hhintoglu/Capstone_Design_by_Project_Automata_Technologies/README.md

# Capstone_Design_by_Project_Automata_Technologies
Capstone Design Project repository. All rights reserved by AutomataTechnologies®
