hhintoglu/Capstone_Design_by_Project_Automata_Technologies/Presentation/Electromechanical Subsystem.pptx

## Electromechanical Subsystem

Huzeyfe Hintoglu

## Outline

- Mechanical Design
- Actuator System Design

## Mechanical Design

- Objectives&Requirements
  - Light and Compact Design
  - Neatness
  - Durability (Mechanically)
  - Inexpensive

## Mechanical Design


## Shooting Mechanism


## Actuator System

- Objectives&Requirements
  - Agile Movement
  - Durability (in Power Aspect)
  - Inexpensive

## Slide 7

Agile Movement

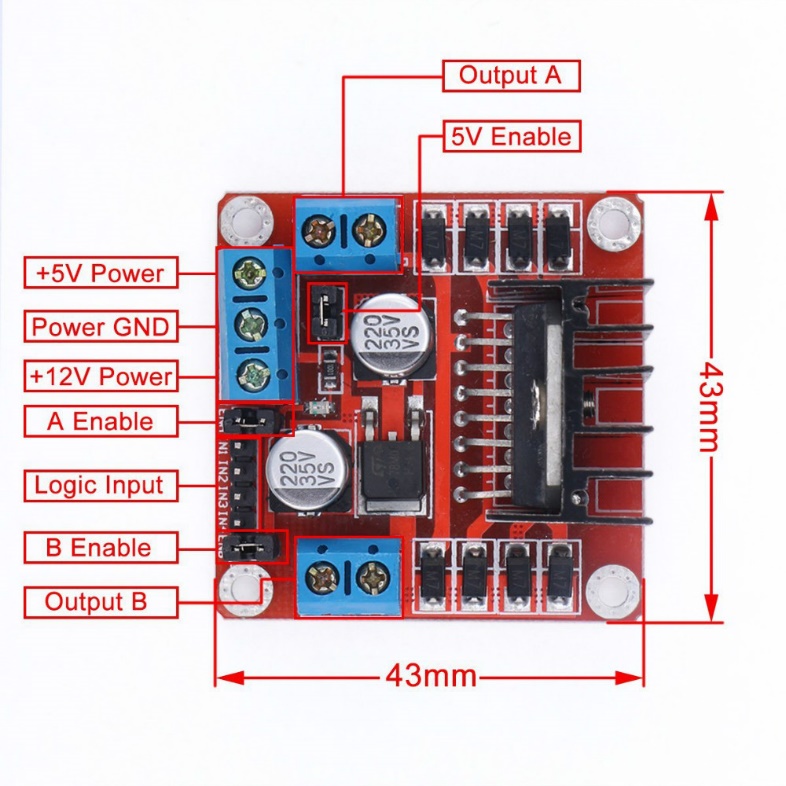
[picture p67: figure]
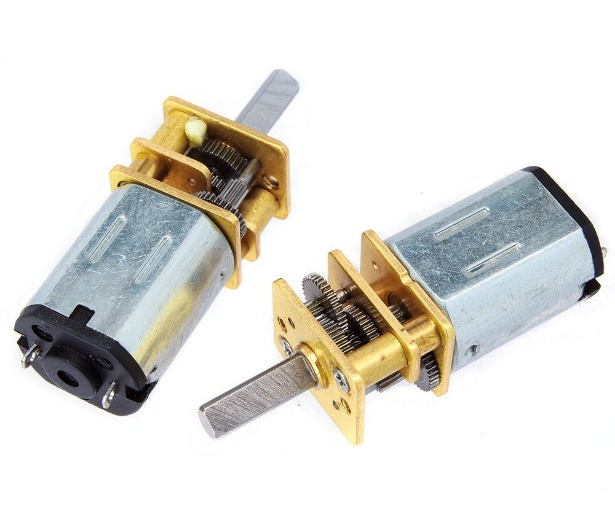
[picture p68: figure]

## Camera Movement

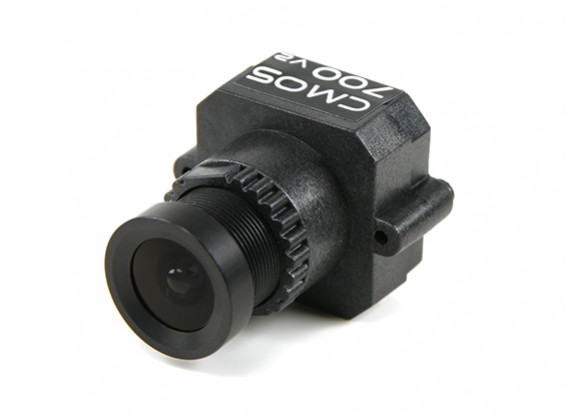
[picture p69: figure]

## Power


5200maH
Li-Po
2Cell 7.4V
30C

## Power Analysis of Robot

Component | Power Consumption
Shooting Mechanism | 0.45W (One shot)
Camera Movement | 0.42W (Continous Rotation)
Camera | 1W
Transmitter | 3.5W
Motor Movement | 4.8W
Reciever | 0.2W
Total | 10.37W
Battery Capacity | 38.5 Wh

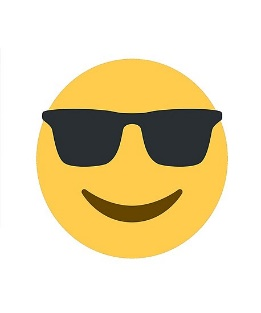
[picture p70: figure]

Time = Battery Capacity/ Total = 4 Hours
