hhintoglu/Capstone_Design_by_Project_Automata_Technologies/Presentation/Control Subsystem.pptx

## Control Subsystem

Fatih ÇALIŞ

## Problem Statement and Requirements

- Good Control Algorithm
  - High Maneuver Capability
- Easeness of the operation
  - 3 Continuous Variables
  - 2 Digital Variables

## Solutions

- Differential Drive Method
  - Rotation around its own axis

## Slide 4

- 3 Continous Variables:
  - Movement in Y direction
  - Movement in X direction
  - Angle of FPV camera
- 2 Digital Variables:
  - Shooting Action
  - Choosing Mode

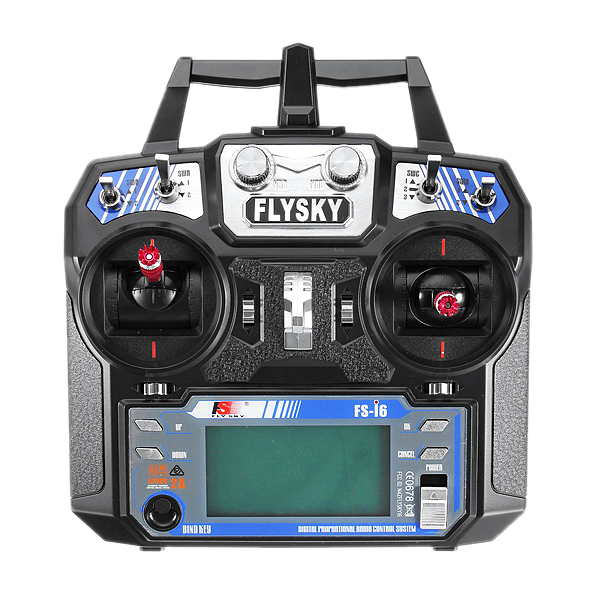
[picture p96: figure]
elektronik eşyalar, kamera, gök içeren bir resim Açıklama otomatik olarak oluşturuldu

## Implementation

Sensors

Microcontroller

RC Transmitter

FPV Display

Remote Control

RC Receiver

Servo Motor

FPV Camera

Motor Driver

Motor Driver

DC Motors

Step Motor

On-Board Control

## Test Results

- RC Transmitter Tests:
  - Range:
    - Line of Sight : Around 250m
    - With Obstacles: Around 100m
- Sensor Tests:
  - Distance Sensor (HCSR-04):
    - Measurement Range: 1cm – 400cm
    - Without Delay : 1cm – 50cm
  - Color Sensor (TCS3200)
    - Requires good threshold adjusting
