hhintoglu/Capstone_Design_by_Project_Automata_Technologies/Presentation/Conclusion.pptx

## CONCLUSION

FATİH ÇAM

## DELIVERABLES

1. Equipments
2. Documents
3. Software

## EQUIPMENTS

- Vehicle(Robot)
- Play Field
- Ball
- Goals
- Control Interface

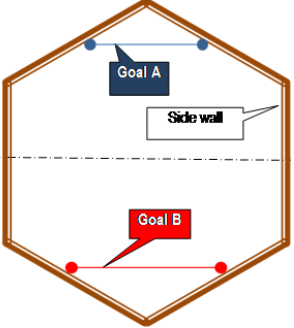
[picture p119: figure]
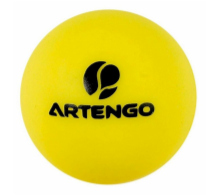
[picture p120: figure]
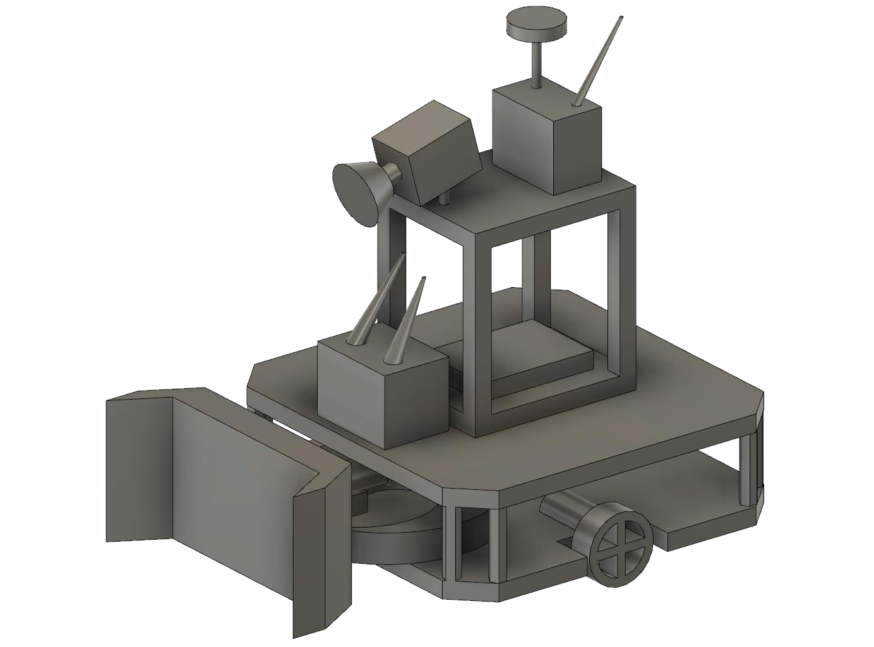
[picture p121: figure]

## DOCUMENTS and SOFTWARE

- Warranty
- Manual
- USB Flash Bellek

## COST ANALYSIS

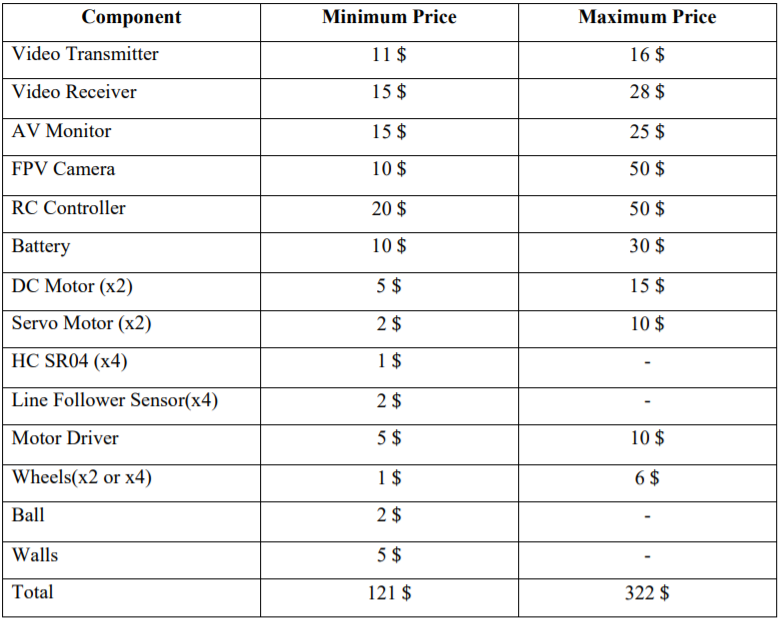
[picture p122: figure]

## TIME PLAN

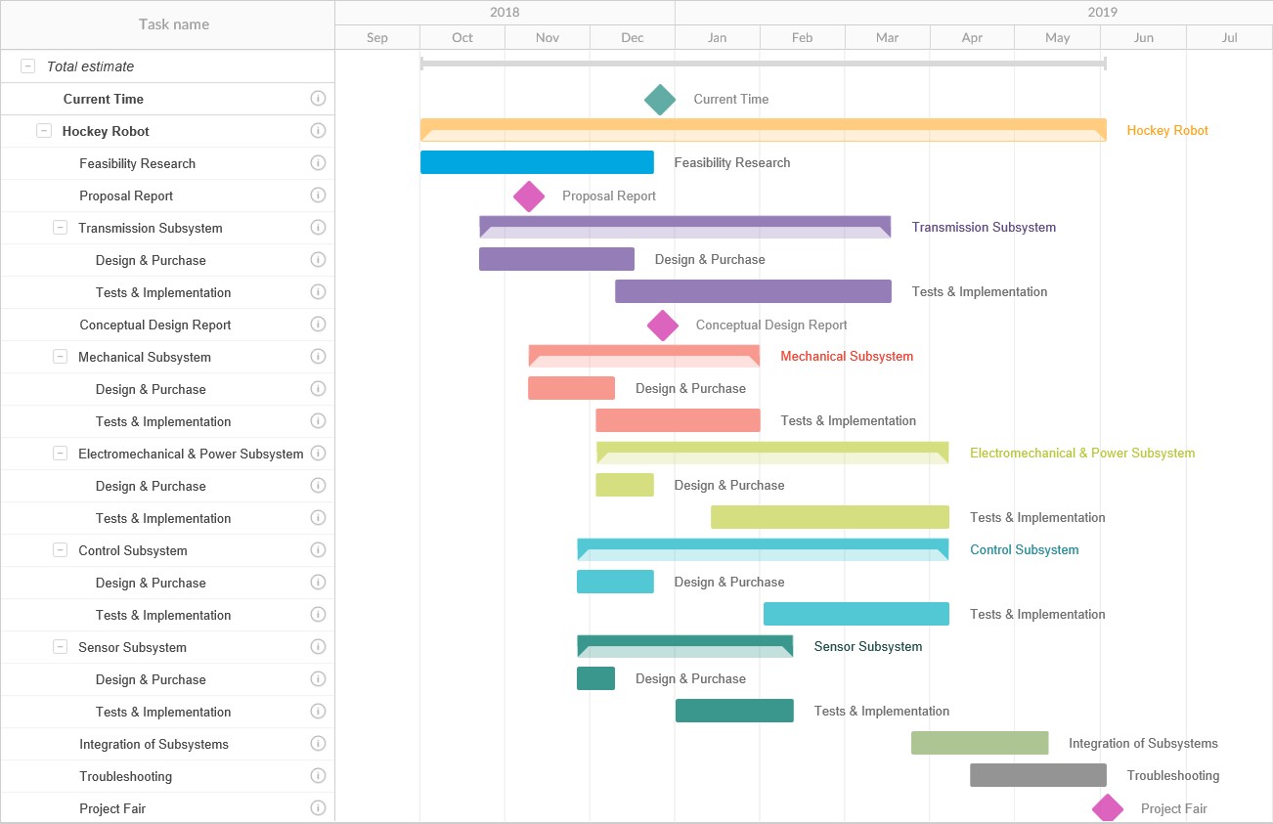
[picture p123: figure]

## FUTURE PLAN

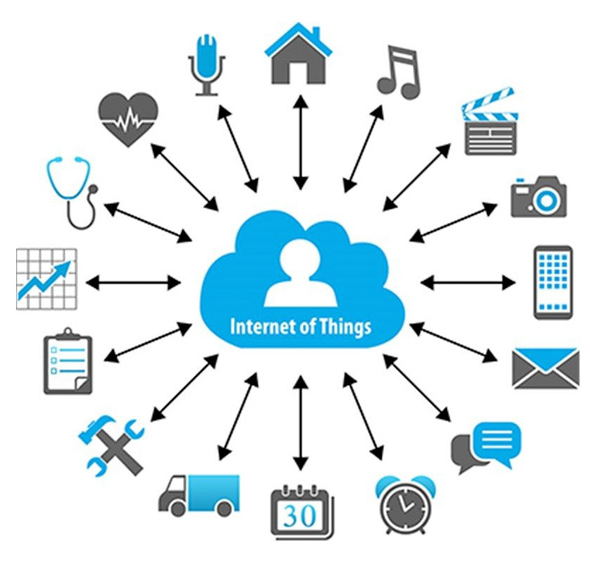
[picture p124: figure]
