hhintoglu/Capstone_Design_by_Project_Automata_Technologies/Presentation/Telecommunication Subsystem.pptx

## Transmission Subsystem

Recep GÜNAY

## Problem Statement and Requirements

- Latency
  - Low latency
- Interference
  - Interference free

## Solutions

## Solutions

- Latency:
  - Analog video data
  - Trade-off between quality
- Interference:
  - Circular Polarized Waves
  - Low signal power
  - Multiple channels in different bands

## Test Results

- Range:
  - 200m in line of sight
  - 40m with obstacles
- Interference:
  - No multipath interference
  - No interference with another system in different channels
- Latency:
  - Less than 80ms within a 10m radius
  - Up to 200ms at around 30m

## Test Results

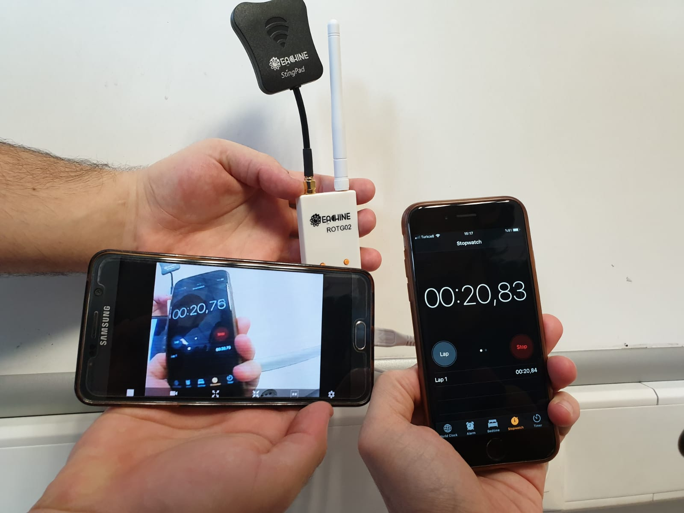
[picture p125: figure]
kişi, tutma, el, duvar içeren bir resim Açıklama otomatik olarak oluşturuldu

## Alternative Solutions

- 3G/4G modules
  - Upload and download video anywhere
- Feature transmission
  - Image processing
