hhintoglu/Capstone_Design_by_Project_Automata_Technologies/3D Drwaings - Final Version/Robot - ISO left Top.png

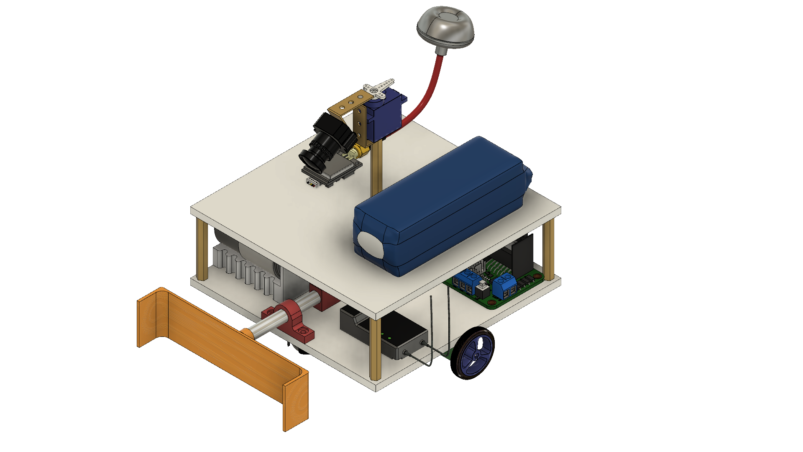
3D Drwaings - Final Version/Robot - ISO left Top.png
