hhintoglu/Capstone_Design_by_Project_Automata_Technologies/Conceptual Design Report/Chassis v1.png

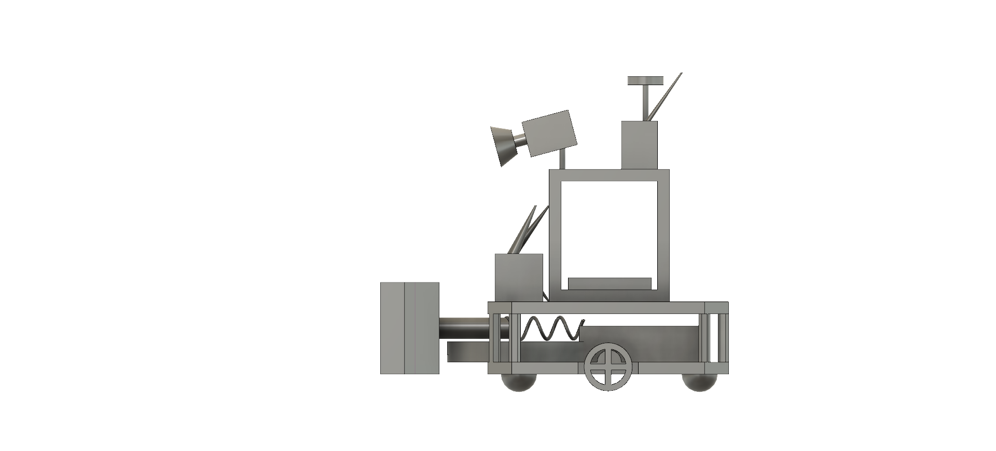
Conceptual Design Report/Chassis v1.png
