hhintoglu/Capstone_Design_by_Project_Automata_Technologies/Conceptual Design Report/Shooting Mech Ver2.png

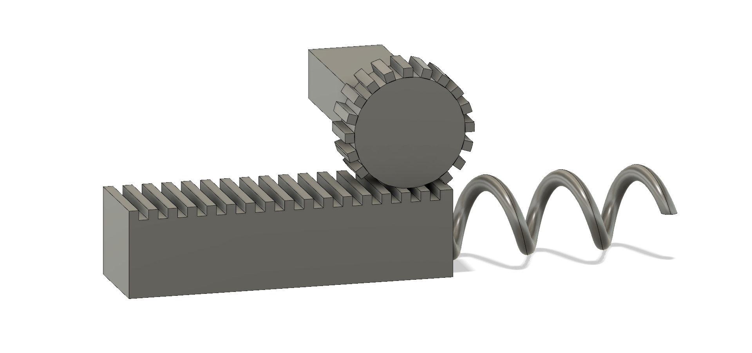
Conceptual Design Report/Shooting Mech Ver2.png
