hhintoglu/Capstone_Design_by_Project_Automata_Technologies/Conceptual Design Report/Spring Mech v9.1.png

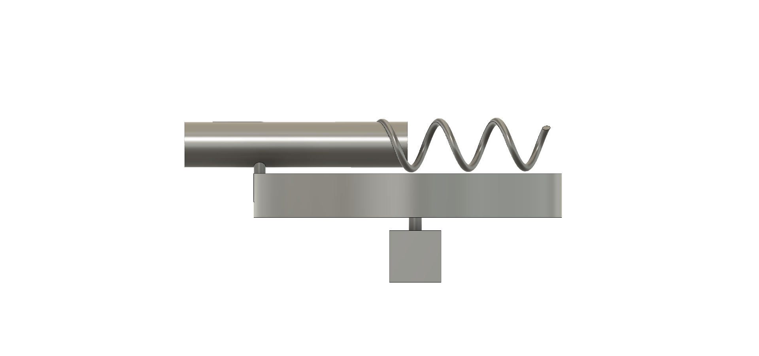
Conceptual Design Report/Spring Mech v9.1.png
