hhintoglu/Capstone_Design_by_Project_Automata_Technologies/Critical Design Report/Chassis Right.png

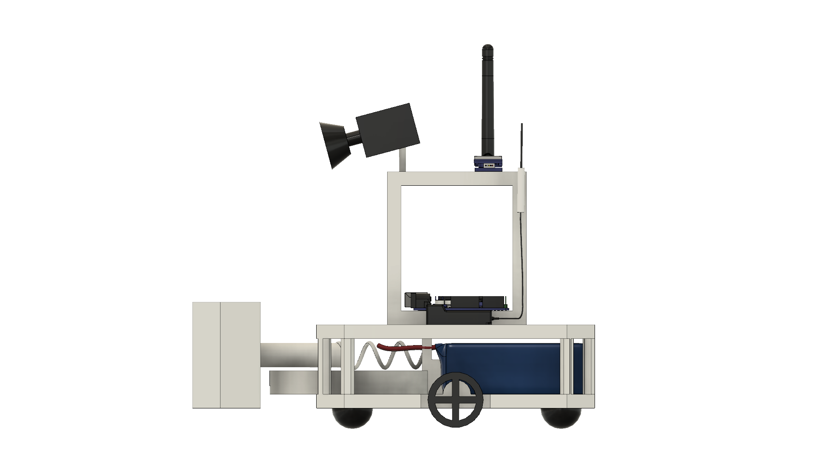
Critical Design Report/Chassis Right.png
