hhintoglu/Capstone_Design_by_Project_Automata_Technologies/Critical Design Report/Chassis TOP.png

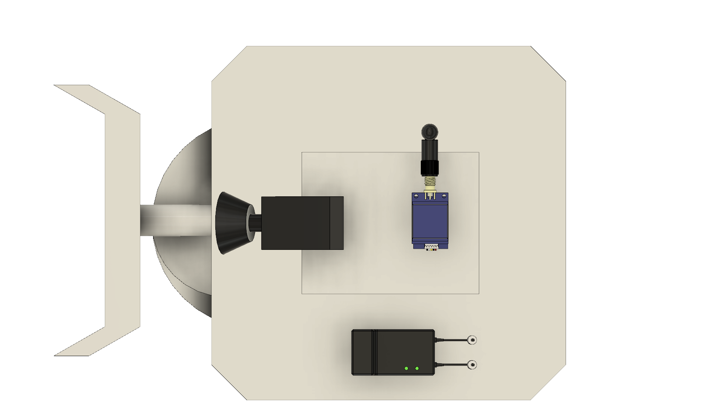
Critical Design Report/Chassis TOP.png
