hhintoglu/Capstone_Design_by_Project_Automata_Technologies/Critical Design Report/Chassis v5.1.png

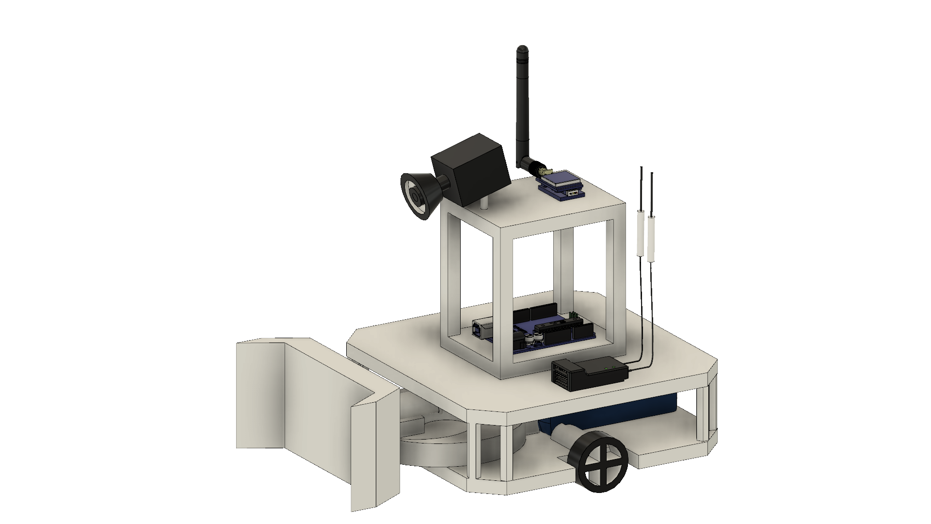
Critical Design Report/Chassis v5.1.png
