hhintoglu/Capstone_Design_by_Project_Automata_Technologies/Financial Management/Cost Analysis.xlsx

Purchase / Contribution | Purchased Component | Total Cost | Date | Link
Purchase | 2* Arduino Nano | 4.02$ (21.56₺) | 2018-10-26 | Aliexpress (https://tr.aliexpress.com/item/1pcs-lot-Nano-3-0-controller-compatible-for-arduino-nano-CH340-USB-driver-NO-CABLE/32824272738.html)
Purchase | 2*NRF24L01 | 3.96$ (21.24₺) | 2018-12-01 | Aliexpress (https://tr.aliexpress.com/item/Free-Shipping-NRF24L01-PA-LNA-Wireless-Module-with-Antenna-1000-Meters-Long-Distance-FZ0410-We-are/32810139818.html)
Purchase | Eachine ROTG02 Receiver | 18.99$ (112.89₺) | 2018-12-13 | Banggood (https://www.banggood.com/Eachine-ROTG02-UVC-OTG-5_8G-150CH-Dual-Antenna-Audio-FPV-Receiver-for-Android-Tablet-Smartphone-p-1242422.html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)
Purchase | Caddx EOS2 FPV Camera | 13.25$ (72.05₺) | 2018-12-15 | Banggood (https://www.banggood.com/Turbo-EOS1-1200TVL-2-1mm-13-CMOS-169-Mini-FPV-Camera-NTSCPAL-For-RC-Drone-p-1278882.html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)
Purchase | Eachine TX801 Transmitter | 12.95$ (70.41₺) | 2018-12-15 | Banggood (https://www.banggood.com/Eachine-TX801-5_8G-72CH-0_01MW5MW25MW50MW100MW200MW400MW600MW-Switched-AV-VTX-FPV-Transmitter-p-1147691.html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) | Total Money:
Purchase | Eachine VR D2 Antenna | 4$ (21.69₺) | 2018-12-15 | Banggood (https://www.banggood.com/Eachine-VR-D2-FPV-Goggles-Spare-Part-RP-SMA-6dBi-5_8GHz-Mushroom-Antenna-p-1086640.html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) | 35.88₺
Purchase | Eachine StingPad Antenna | 5$ (27.13₺) | 2018-12-15 | Banggood (https://www.banggood.com/Eachine-StingPad-5_8G-16dBi-High-Gain-Flat-Panel-FPV-Antenna-SMARP-SMA-For-Receiver-p-1155223.html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)
Contribution (Huzeyfe) | - | 150₺ | 2018-12-21 | -
Contribution (Sarah) | - | 150₺ | 2018-12-27 | -
Contribution (Fatih Çalış) | - | 150₺ | 2018-12-29 | -
Purchase | 3*DC Motor 6V 350RPM | 97.42₺ | 2018-12-30 | Robotzade (https://www.robotzade.com/6V-350Rpm-Reduktorlu-Mikro-DC-Motor,PR-1171.html)
Purchase | Tplug,Macarons,Cables etc | 41,63₺ | 2018-12-31 | Robotistan (https://www.robotistan.com/t-plug-yuksek-akim-konektor-seti-40-80a)
Contribution (Fatih ÇAM) | - | 150₺ | 2019-01-08 | -
Contribution (Recep) | - | 150₺ | 2019-01-09 | -
Purchase (3D Print) | Motor Mount x 3 | 6₺ | 2019-02-25 | -
Purchase (3D Print) | Spiral V3. + Adapter | 14.50₺ | 2019-03-06 | -
Purchase | Rail | 9.75₺ | 2019-03-06 | -
Purchase (3D Print) | Rack and Pinion v1 | 3₺ | 2019-03-15 | -
Purchase | Aluminum Rod | 20₺ | 2019-03-20 | -
Purchase (3D Print) | Rack and Pinon v3 | 5₺ | 2019-03-26 | -
Purchase | Seperator 8x8cm 8x2.5cm | 13₺ | 2019-03-26 | -
Purchase | 12V 30RPM DC Motor | 99.49₺ | 2019-03-29 | Robotzade (https://www.robotzade.com/index.php?do=catalog/product&pid=1575)
Purchase (3D Print) | Mounts | 20₺ | 2019-04-02
Purchase (3D Print) | Shooting Plate | 6.5₺ | 2019-05-11 | -
Purchase (2D Print) | Poster | 27.5₺ | 2019-05-13 | -
