hhintoglu/Capstone_Design_by_Project_Automata_Technologies/Weekly Progress Reports/1st Semester/Week2/Project Ratings.xlsx

 | Experience | Fun | Creativity | Cheapness | Marketability | Easiness
Weights: | 0.262 | 0.19 | 0.262 | 0.48 | 0.143 | 0.95 | : These weight are not correct. They are put to test the formulas to calculate the point of a project
Fatih ÇAM | Experience | Fun | Creativity | Cheapness | Marketability | Easiness | Total Points
Catching Balloons | 6 | 6 | 4 | 6 | 4 | 6 | 5.65 |  | Results:
Hockey | 8 | 10 | 10 | 4 | 10 | 8 | 7.68 | Catching Balloons: | 5.41
Chasing each other | 4 | 6 | 6 | 8 | 4 | 8 | 6.90 | Hockey: | 6.96
Mappping | 8 | 4 | 10 | 4 | 6 | 2 | 4.44 | Chasing: | 6.05
 |  |  |  |  |  | 8 |  | Mapping | 4.04
Fatih ÇALIŞ | Experience | Fun | Creativity | Cheapness | Marketability | Easiness
Catching Balloons | 6 | 4 | 4 | 8 | 0 | 6 | 5.65
Hockey | 8 | 10 | 10 | 4 | 8 | 8 | 7.56
Chasing each other | 8 | 6 | 6 | 6 | 4 | 4 | 5.27
Mappping | 10 | 8 | 10 | 4 | 8 | 0 | 4.30
Recep GÜNAY | Experience | Fun | Creativity | Cheapness | Marketability | Easiness
Catching Balloons | 6 | 4 | 6 | 6 | 4 | 4 | 4.88
Hockey | 4 | 8 | 6 | 4 | 6 | 8 | 6.35
Chasing each other | 4 | 4 | 4 | 8 | 4 | 8 | 6.50
Mappping | 8 | 6 | 8 | 2 | 6 | 2 | 3.96
H. HİNTOĞLU | Experience | Fun | Creativity | Cheapness | Marketability | Easiness
Catching Balloons | 6 | 6 | 4 | 4 | 4 | 6 | 5.23
Hockey | 8 | 10 | 10 | 4 | 10 | 6 | 6.85
Chasing each other | 4 | 2 | 4 | 4 | 2 | 10 | 6.20
Mappping | 8 | 4 | 8 | 2 | 10 | 2 | 4.04
Sarah ILYAS | Experience | Fun | Creativity | Cheapness | Marketability | Easiness
Catching Balloons | 6 | 6 | 4 | 6 | 4 | 6 | 5.65
Hockey | 8 | 9 | 10 | 2 | 10 | 6 | 6.35
Chasing each other | 4 | 4 | 4 | 2 | 6 | 8 | 5.37
Mappping | 4 | 4 | 8 | 2 | 8 | 2 | 3.46
 | 6.00 | 5.20 | 4.40 | 6.00 | 3.20 | 5.60
 | 7.20 | 9.40 | 9.20 | 3.60 | 8.80 | 7.20
 | 4.80 | 4.40 | 4.80 | 5.60 | 4.00 | 7.60
 | 7.60 | 5.20 | 8.80 | 2.80 | 7.60 | 1.60
