hhintoglu/Capstone_Design_by_Project_Automata_Technologies/Conceptual Design Report/Chassisv2.stl

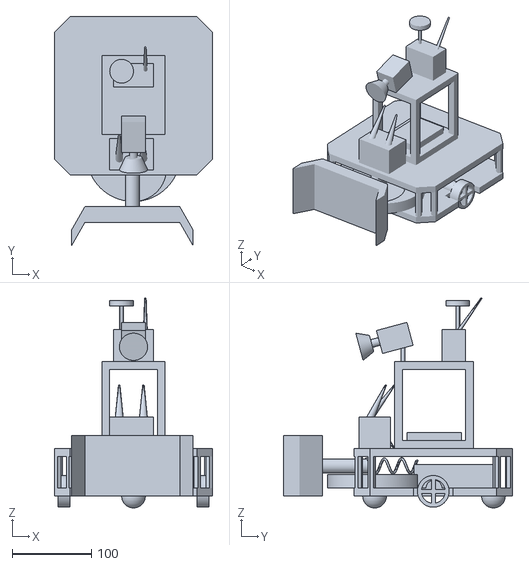
[picture p144: CAD file, 2019-07-23]
Conceptual Design Report/Chassisv2.stl
200.0 x 289.1 x 265.0
